efournie/BeeMon/beemon.ino

#include <DHT.h>
#include <ESP8266WiFi.h>
#include <ESP8266HTTPClient.h>
#include <HX711.h>
#include <LiquidCrystal_I2C.h>
#include <DallasTemperature.h>
#include <OneWire.h>

// Settings
const int LCD_SCREEN = 0;
const int WEB_SERVER = 1;
const int WEIGHT_SENSOR = 0;
const int TEST_MODE = 0;
const int DEEP_SLEEP_TIME_SEC = 600;
const int WIFI_INIT_MAX_SEC = 15;

// Web server
const char *ssid = "ssid";
const char *password = "password";

const int SCALE_DOUT_PIN = 14;  // = D5
const int SCALE_SCK_PIN = 12;   // = D6
const int DHT2PIN = 13;         // = D7
const int EXT_TEMP_PIN = 2;     // = D4
const int BATTERY_PIN = A0;
const long  SCALE_CALIBRATION_OFFSET  = -29;
const float SCALE_CALIBRATION_FACTOR  = 7085;
long channelA;

HX711 scale;
DHT dht(DHT2PIN, DHT22);
LiquidCrystal_I2C lcd(0x27, 16, 2);
OneWire oneWire(EXT_TEMP_PIN);
DallasTemperature sensors(&oneWire);


///
/// Setup
///
void setup() 
{
  //  Initialize everything
  Serial.begin(115200);
  Serial.setTimeout(2000);
  // Wait for serial to initialize.
  while(!Serial) { }
  delay(500);
  Serial.println("Serial port initialized.");
  pinMode(BATTERY_PIN, INPUT);
  pinMode(D0, WAKEUP_PULLUP);
  turnOnPeripherals();

  // Wait 5 seconds, read sensors and publish results to LCD and/or web server
  delay(5000);
  float voltage = getBattery();
  float temp = getTemp();
  float humidity = getHumidity();
  float extTemp = getExtTemp();
  float weight = getWeight(extTemp);

  if(!TEST_MODE)
  {
    if(LCD_SCREEN) lcdOut(weight, temp, humidity, voltage);
    if(WEB_SERVER) webOut(weight, temp, humidity, voltage, extTemp);
    delay(5000);
    turnOffPeripherals();
  }
}


///
/// Peripherals on / off
///

void turnOnPeripherals()
{
  if(LCD_SCREEN)
  {
    Serial.println("LCD initialization...");
    lcd.init();   // initializing the LCD
    lcd.backlight();
    clearLcd();
    lcd.setCursor(0, 0);
    lcd.print("BeeMon");
    lcd.setCursor(0, 1);
    lcd.print("Init.");
  }
  if(WEB_SERVER)
  {
    WiFi.begin(ssid, password);
    Serial.println("Connecting to WiFi");
    int wait_sec = 0;
    while(WiFi.status() != WL_CONNECTED && wait_sec < WIFI_INIT_MAX_SEC)
    {
      delay(1000);
      Serial.print(".");
      wait_sec++;
    }
    if(wait_sec == WIFI_INIT_MAX_SEC)
    {
      Serial.println("WiFi connection failed.");
    }
    if (WiFi.status() == WL_CONNECTED && LCD_SCREEN)
    {
       lcd.setCursor(15, 0);
       lcd.print("w");
    }
    Serial.println("");
    Serial.print("Connected to WiFi network with IP Address: ");
    Serial.println(WiFi.localIP());
  }
  if (LCD_SCREEN)
  {
    lcd.setCursor(5,1);
    lcd.print(".");
  }
  if (WEIGHT_SENSOR)
  {
    scale.begin(SCALE_DOUT_PIN, SCALE_SCK_PIN);
    scale.power_up();
    delay(2000); // After first powerup, the HX711 seems to need more time before being able to read values...  
  }
  Serial.println("Temperature and humidity sensor initialization...");
  dht.begin(); // initialize dht22
  if (LCD_SCREEN)
  {
    lcd.setCursor(6,1);
    lcd.print(".");
  }
  Serial.println("All sensors initialized!");
}

void turnOffPeripherals()
{
  Serial.println("Turning off peripherals and activating deep sleep for " + String(DEEP_SLEEP_TIME_SEC) + "seconds...");
  if (LCD_SCREEN) 
  {
    lcd.setCursor(15, 1);
    lcd.print("z");
  }
  if (WEIGHT_SENSOR) scale.power_down();
  Serial.flush();
  ESP.deepSleep(DEEP_SLEEP_TIME_SEC * 1e6, WAKE_RFCAL);
}

void clearLcd()
{
  lcd.clear();
  if (WiFi.status() == WL_CONNECTED && LCD_SCREEN)
  {
     lcd.setCursor(15, 0);
     lcd.print("w");
  }  
}

float getBattery()
{
   float volt = analogRead(BATTERY_PIN);
   return volt/233.8;
}


///
/// Sensors reading
///

float getTemp()
{
  float temp = dht.readTemperature();
  if (isnan(temp) || (temp < -30.0) || (temp > 60.0))
  {
    Serial.println("DHT22 temperature reading seems wrong:" + String(temp));
    temp = -127;
  }
  return temp;
}

float getExtTemp()
{
  sensors.requestTemperatures(); 
  float temperature = sensors.getTempCByIndex(0);
  return temperature;
}
  
float getHumidity()
{
  float humidity = dht.readHumidity();
  if (isnan(humidity) || (humidity < 0.0) || (humidity > 100.0))
  {
    Serial.println("DHT22 humidity reading seems wrong:" + String(humidity));
    humidity = -127;
  }
  return humidity;
}
  
float getWeight(float extTemp)
{
  if (!WEIGHT_SENSOR) return 0;
  float weight;
  if (scale.is_ready()) 
  {
    scale.read();
    channelA = scale.read_average(3);
    Serial.println("HX711: channel A: " + String((float)channelA));
  } else {
    Serial.println("HX711 not found.");
    weight = 0.0;
  }
  if(extTemp != -127)
  {
    float tempCorrection = -extTemp * 3630.7;
    weight = (channelA + tempCorrection) / SCALE_CALIBRATION_FACTOR + SCALE_CALIBRATION_OFFSET; 
  }
  else
  {
    // Reading error, weight measure should not be used
    weight = 0;
  }
  Serial.println("Weight: " + String(weight,3) + "kg (corrected for temp=" + String(extTemp, 3) + "C)");
  return weight;
}


///
/// Publish results
///

void lcdOut(float weight, float temp, float humidity, float voltage)
{
  if(!LCD_SCREEN) return;
  String line1=String(weight, 1) + "kg  " + String(temp, 1)+"C";
  String line2=String(humidity, 1) + "%  " + String(voltage, 2) + "V";
  clearLcd();
  lcd.setCursor(0, 0);
  lcd.print(line1);
  lcd.setCursor(0, 1);
  lcd.print(line2);
}

void webOut(float weight, float temp, float humidity, float voltage, float extTemp)
{
  String temperature_url = "http://192.168.1.100:1974/store_hive_temp.php";
  String temperature_data = "temp_sensor=" + String(temp, 1);
  String humidity_url = "http://192.168.1.100:1974/store_hive_humidity.php";
  String humidity_data = "humidity_sensor=" + String(humidity, 1);
  String weight_url = "http://192.168.1.100:1974/store_hive_weight.php";
  String weight_data = "weight_sensor=" + String(weight, 3);
  String battery_url = "http://192.168.1.100:1974/store_hive_battery.php";
  String battery_data = "battery=" + String(voltage, 3);
  String channela_url = "http://192.168.1.100:1974/store_hive_channela.php";
  String channela_data = "channela=" + String((float)channelA, 1);
  String exttemp_url = "http://192.168.1.100:1974/store_hive_exttemp.php";
  String exttemp_data = "temp_sensor=" + String((float)extTemp, 3);

  if(temp != -127) postReading(temperature_url, temperature_data);
  if(humidity != -127) postReading(humidity_url, humidity_data);
  if(weight != 0 && WEIGHT_SENSOR) postReading(weight_url, weight_data); // Don't sent weight if it is invalid
  postReading(battery_url, battery_data);
  postReading(channela_url, channela_data);
  if(extTemp != -127) postReading(exttemp_url, exttemp_data);
}

void postReading(String url, String data)
{
  Serial.println("Posting " + data + " to " + url + "...");
  if(WiFi.status()== WL_CONNECTED)
  {
    HTTPClient http;
    http.begin(url);
    http.addHeader("Content-Type", "application/x-www-form-urlencoded");
    int httpResponseCode = http.POST(data);
    String payload = http.getString();
    if (httpResponseCode <= 0)
    {
      Serial.print("Error code: ");
      Serial.println(httpResponseCode);
    }
    http.end();
  }
  else
  {
    Serial.println("WiFi Disconnected");
  }
}


///
/// Main loop
///

void loop() 
{
  if(TEST_MODE)
  {
    delay(5000);
    float extTemp = getExtTemp();
    Serial.println("External (reference) temperature: " + String(extTemp, 2) + "C");
    float weight = getWeight(extTemp);
    Serial.println("Weight: " + String(weight, 2) + "kg");
    float voltage = getBattery();
    Serial.println("Battery: " + String(voltage, 2));
    float temp = getTemp();
    Serial.println("Temperature: " + String(temp, 2) + "C");
    float humidity = getHumidity();
    Serial.println("Humidity: " + String(humidity, 2) + "%");
    if(LCD_SCREEN) lcdOut(weight, temp, humidity, voltage);
    webOut(weight, temp, humidity, voltage, extTemp);
  }
}
