efournie/BeeMon/(commit log)

2021-04-13 schematics added, deep sleep added
    [beemon.kicad_pcb, beemon.sch, beemon_components.kicad_pcb, beemon_components.sch]
2021-04-13 HTTP POST handling added
    [beemon.sch]
2021-04-15 Code fixed and tested on 1st prototype. Schematics modified.
    [beemon.sch]
2021-04-16 Fix schematics error
    [beemon.sch]
2021-04-17 Update every 10 minutes. 3 digits precision for voltage. Weight sensors properly calibrated
2021-04-26 Clean weight sensor board, good weight readings
    [beemon.sch]
2021-04-28 Temp sensor added to compensate Seebeck effect. Weight sensors properly calibrated.
    [beemon.sch]
2021-04-29 Calibration modified, fail mode for external temp.
    [beemon.ino]
2021-06-28 Value checks
    [beemon.sch]
2021-06-29 Possibility to disable the weight sensor
